ling7334/LiRey/img/lolin_lite.jpg

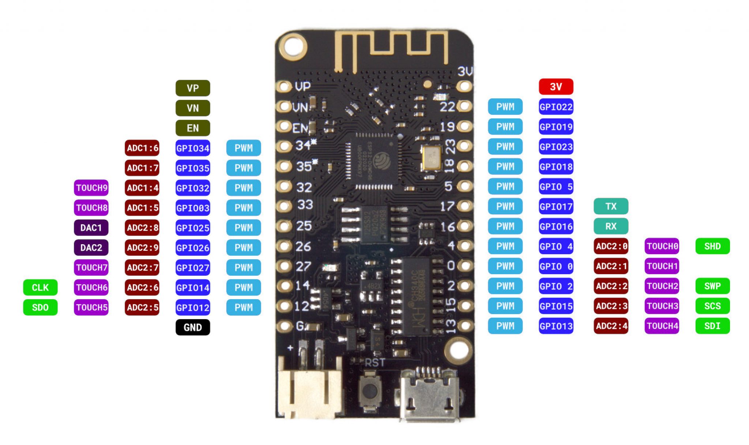
img/lolin_lite.jpg
