ling7334/LiRey/img/pn5180.jpg

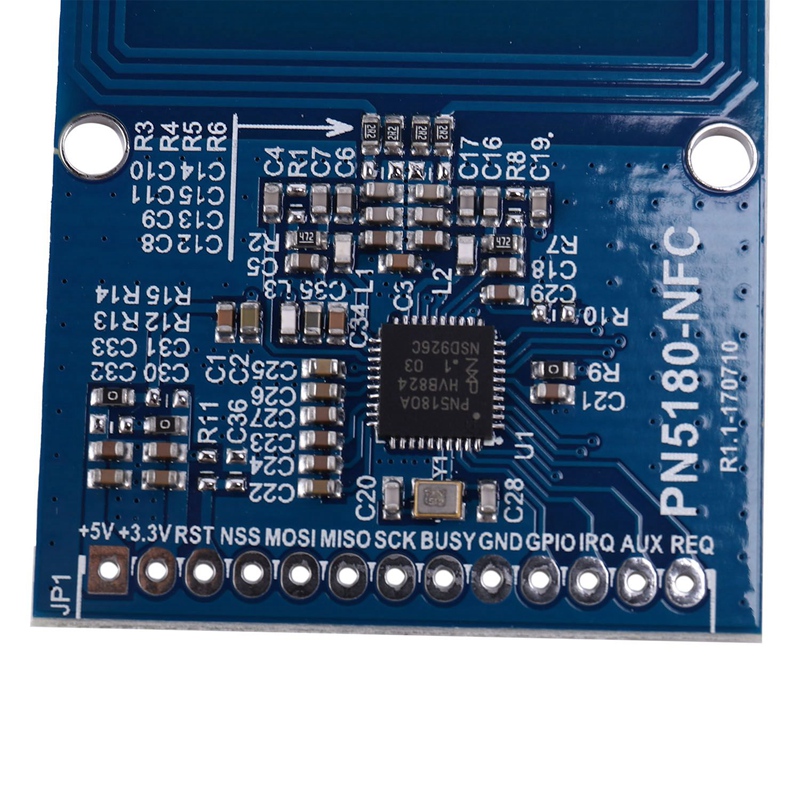
img/pn5180.jpg
